mengels3/proteus-platform/doc/paper/figures/Prediction.png

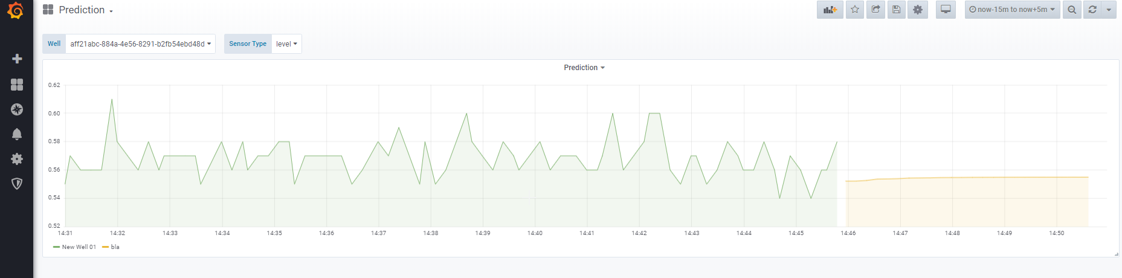
doc/paper/figures/Prediction.png
