mengels3/proteus-platform/well-admin-dashboard/src/assets/drop.png

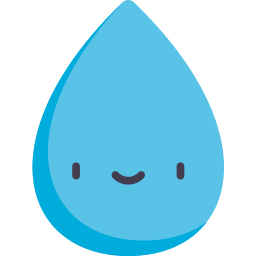
well-admin-dashboard/src/assets/drop.png
