mengels3/proteus-platform/(commit log)

2019-11-27 water level sensor
2020-01-06 wip: Measurements now are rather key-value pairs than full-blown sensor-specific POJOs
2020-01-08 wip: all sensor types endpoint
2020-01-08 * sketch to read all sensor data
2020-01-08 * main sketch with arduino
2020-01-08 wip: added a proper sensor data DTO
2020-01-11 add sensor types input for create-well-modal
2020-01-11 fix: handle URL-encoded sensor data
2020-01-15 sensor-types getting fetched from api and being displayed correctly
2020-02-04 removed obsolete Arduino sketches
